greenenergyprojects/rpi-atmega324-modbus-gateway/kicad/dist/rpi-atmega324-modbus-gateway-min_image-bottom.png

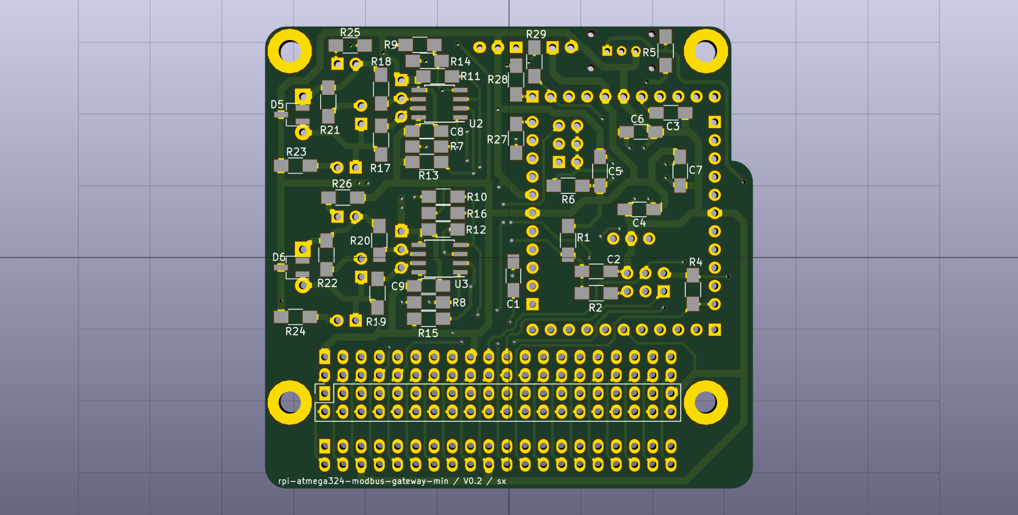
kicad/dist/rpi-atmega324-modbus-gateway-min_image-bottom.png
