greenenergyprojects/rpi-atmega324-modbus-gateway/README.md

# rpi-atmega324-modbus-gateway
Modbus Gateway for Raspberry PI
