greenenergyprojects/rpi-atmega324-modbus-gateway/kicad/prototype/pinning.odt

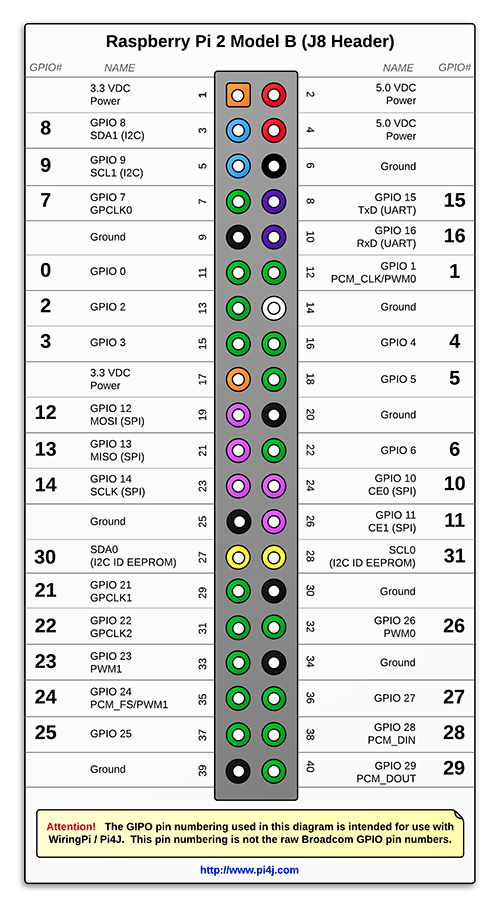
[picture p3: figure]
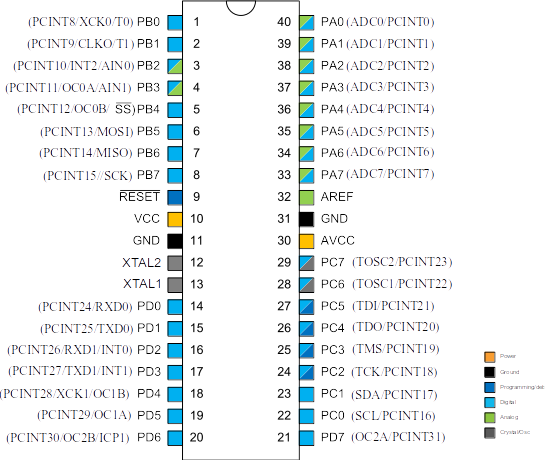
[picture p4: figure]
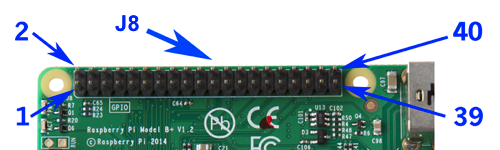
[picture p5: figure]
