greenenergyprojects/rpi-atmega324-modbus-gateway/kicad/dist/rpi-atmega324-modbus-gateway-min_bom.ods

Source: | /work/sx/gep/rpi-atmega324-modbus-gateway/kicad/rpi-atmega324-modbus-gateway-min.sch
Date: | Fr 31 Aug 2018 14:42:01 CEST
Tool: | Eeschema 4.0.7-e2-6376~61~ubuntu18.04.1
Component Count: | 73
Ref | Value | Footprint | Datasheet | Manufacturer | Vendor
C1 | 100n | Capacitors_SMD:C_1206_HandSoldering
C2 | 1n | Capacitors_SMD:C_1206_HandSoldering
C3 | 100n | Capacitors_SMD:C_1206_HandSoldering
C4 | 100n | Capacitors_SMD:C_1206_HandSoldering
C5 | 100n | Capacitors_SMD:C_1206_HandSoldering
C6 | 100n | Capacitors_SMD:C_1206_HandSoldering
C7 | 100n | Capacitors_SMD:C_1206_HandSoldering
C8 | 100n | Capacitors_SMD:C_1206_HandSoldering
C9 | 100n | Capacitors_SMD:C_1206_HandSoldering
D1 | LED | LEDs:LED_0805_HandSoldering
D2 | LED | LEDs:LED_0805_HandSoldering
D3 | LED | LEDs:LED_0805_HandSoldering
D4 | LED | LEDs:LED_0805_HandSoldering
D5 | D_TVS_x2_AAC | TO_SOT_Packages_SMD:SOT-23_Handsoldering
D6 | D_TVS_x2_AAC | TO_SOT_Packages_SMD:SOT-23_Handsoldering
D7 | LED | LEDs:LED_0805_HandSoldering
D8 | LED | LEDs:LED_0805_HandSoldering
D9 | LED | LEDs:LED_0805_HandSoldering
J1 | Raspberry_Pi_2+ | Project:RPI_DINRAILBOX_4TE_72mmx91mm_DEBUG
J2 | UART-Harwin3 | Connectors_Harwin:Harwin_LTek-Male_03x2.00mm_Straight_StrainRelief
J3 | Conn_01x02 | Pin_Headers:Pin_Header_Straight_1x02_Pitch2.54mm
J4 | Conn_02x03_Odd_Even | Project:Jumper_3x_2x03_Pitch2.54mm
J5 | Atmega-ISP-6 | Project:IDC_2x3x2.54mm_Straight
J6 | Conn_01x03 | Pin_Headers:Pin_Header_Straight_1x03_Pitch2.54mm
J7 | Conn_01x03 | Pin_Headers:Pin_Header_Straight_1x03_Pitch2.54mm
J8 | Conn_01x02 | Pin_Headers:Pin_Header_Straight_1x02_Pitch2.54mm
J9 | Conn_01x02 | Pin_Headers:Pin_Header_Straight_1x02_Pitch2.54mm
J10 | Conn_01x02 | Pin_Headers:Pin_Header_Straight_1x02_Pitch2.54mm
J11 | Conn_01x02 | Pin_Headers:Pin_Header_Straight_1x02_Pitch2.54mm
J12 | Conn_01x02 | Pin_Headers:Pin_Header_Straight_1x02_Pitch2.54mm
J13 | Conn_01x02 | Pin_Headers:Pin_Header_Straight_1x02_Pitch2.54mm
J14 | Screw_Terminal_01x02 | Project:Terminalblock-2x-5mm
J15 | Screw_Terminal_01x02 | Project:Terminalblock-2x-5mm
J16 | Conn_01x11 | Pin_Headers:Pin_Header_Straight_1x11_Pitch2.54mm
J17 | Conn_01x11 | Pin_Headers:Pin_Header_Straight_1x11_Pitch2.54mm
J18 | Conn_01x11 | Pin_Headers:Pin_Header_Straight_1x11_Pitch2.54mm
J19 | Conn_01x11 | Pin_Headers:Pin_Header_Straight_1x11_Pitch2.54mm
JP1 | Jumper_NC_Small | Project:SOLDER-JUMPER_1-WAY
R1 | 10K | Resistors_SMD:R_1206_HandSoldering
R2 | 10K | Resistors_SMD:R_1206_HandSoldering
R3 | 47K | Resistors_SMD:R_1206_HandSoldering
R4 | 47K | Resistors_SMD:R_1206_HandSoldering
R5 | 47K | Resistors_SMD:R_1206_HandSoldering
R6 | 47K | Resistors_SMD:R_1206_HandSoldering
R7 | 560R | Resistors_SMD:R_1206_HandSoldering
R8 | 560R | Resistors_SMD:R_1206_HandSoldering
R9 | 560R | Resistors_SMD:R_1206_HandSoldering
R10 | 560R | Resistors_SMD:R_1206_HandSoldering
R11 | 47K | Resistors_SMD:R_1206_HandSoldering
R12 | 47K | Resistors_SMD:R_1206_HandSoldering
R13 | 47K | Resistors_SMD:R_1206_HandSoldering
R14 | 47K | Resistors_SMD:R_1206_HandSoldering
R15 | 47K | Resistors_SMD:R_1206_HandSoldering
R16 | 47K | Resistors_SMD:R_1206_HandSoldering
R17 | 10R | Resistors_SMD:R_1206_HandSoldering
R18 | 10R | Resistors_SMD:R_1206_HandSoldering
R19 | 10R | Resistors_SMD:R_1206_HandSoldering
R20 | 10R | Resistors_SMD:R_1206_HandSoldering
R21 | 150R | Resistors_SMD:R_1206_HandSoldering
R22 | 150R | Resistors_SMD:R_1206_HandSoldering
R23 | 330R | Resistors_SMD:R_1206_HandSoldering
R24 | 330R | Resistors_SMD:R_1206_HandSoldering
R25 | 330R | Resistors_SMD:R_1206_HandSoldering
R26 | 330R | Resistors_SMD:R_1206_HandSoldering
R27 | 560R | Resistors_SMD:R_1206_HandSoldering
R28 | 560R | Resistors_SMD:R_1206_HandSoldering
R29 | 560R | Resistors_SMD:R_1206_HandSoldering
SW1 | SW_Push | Buttons_Switches_SMD:SW_SPST_FSMSM
SW2 | SW_SPST | Project:SW-ebay-171865305033
U1 | ATMEGA324P-20AU | Project:TQFP-44_10x10mm_Pitch0.8mm_Handsolded
U2 | SN65HVD11 | Project:SOIC-8_3.9x4.9mm_Pitch1.27mm_Handsolded
U3 | SN65HVD11 | Project:SOIC-8_3.9x4.9mm_Pitch1.27mm_Handsolded
Y1 | 12MHz | Crystals:Resonator-3pin_w7.0mm_h2.5mm
