greenenergyprojects/rpi-atmega324-modbus-gateway/software/atmega324p/simple-gateway/measurements/osci/modbus_gateway_oszi_2018-08-08_08-25.png

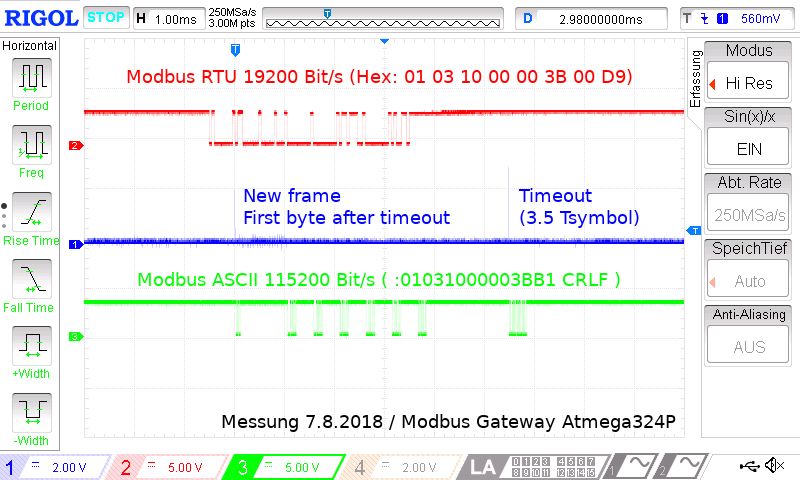
software/atmega324p/simple-gateway/measurements/osci/modbus_gateway_oszi_2018-08-08_08-25.png
