greenenergyprojects/rpi-atmega324-modbus-gateway/kicad/dist/rpi-atmega324-modbus-gateway-min_schematic-bw.pdf

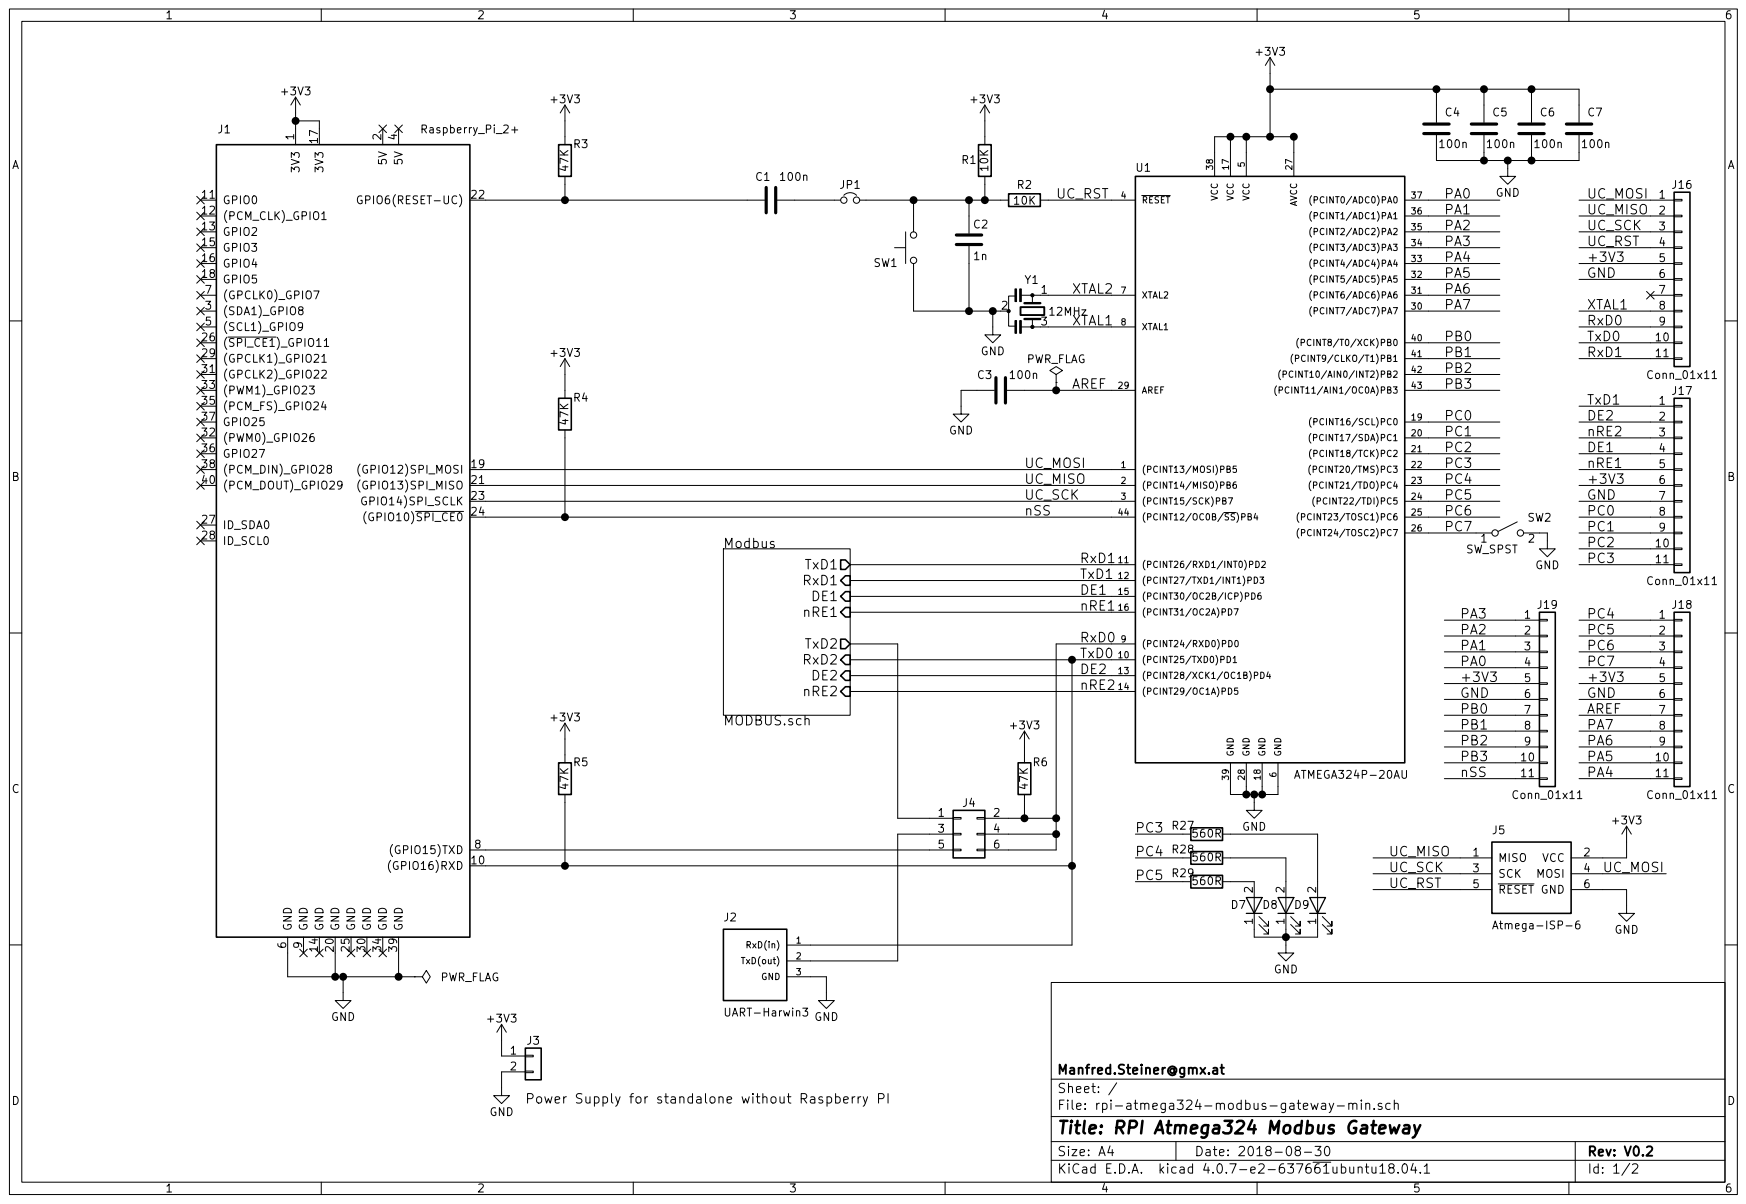
[picture p7: page 1]

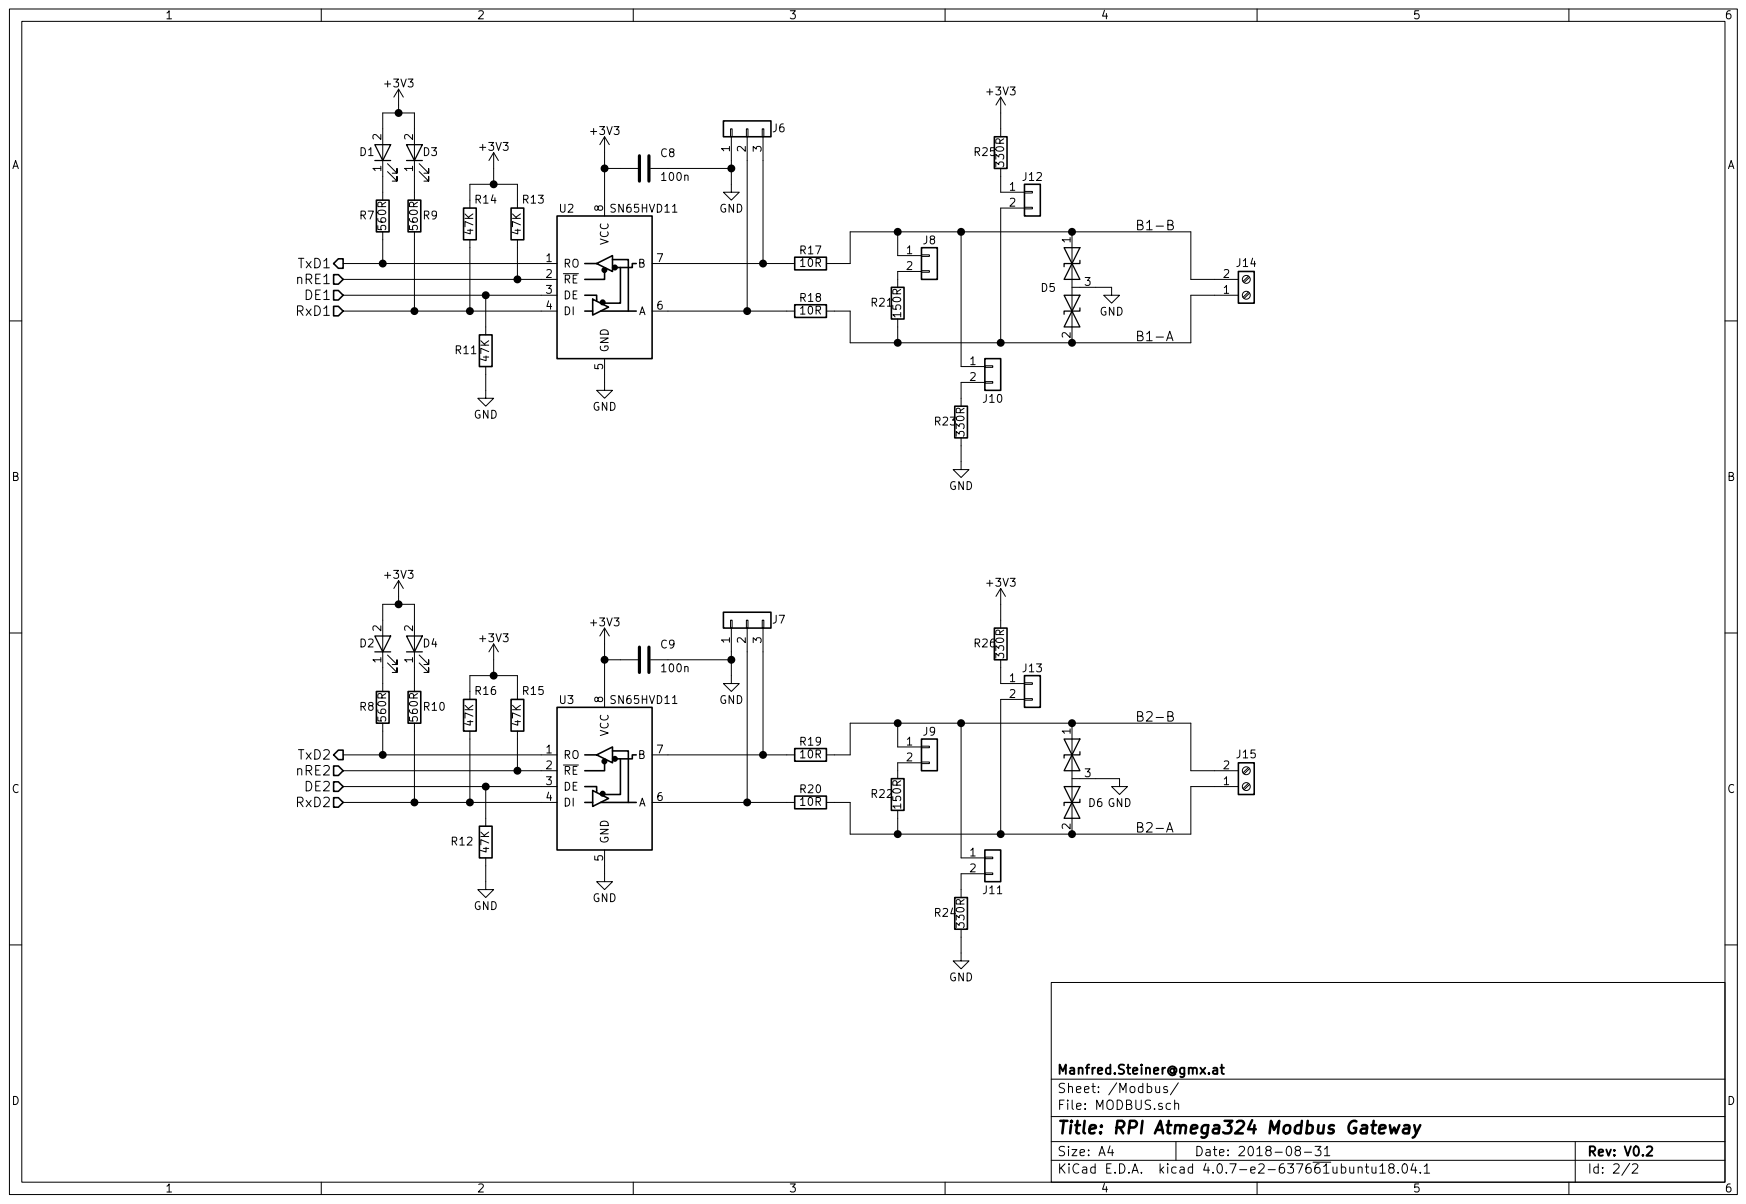
[picture p8: page 2]
