greenenergyprojects/rpi-atmega324-modbus-gateway/kicad/dist/rpi-atmega324-modbus-gateway-min_schematic.pdf

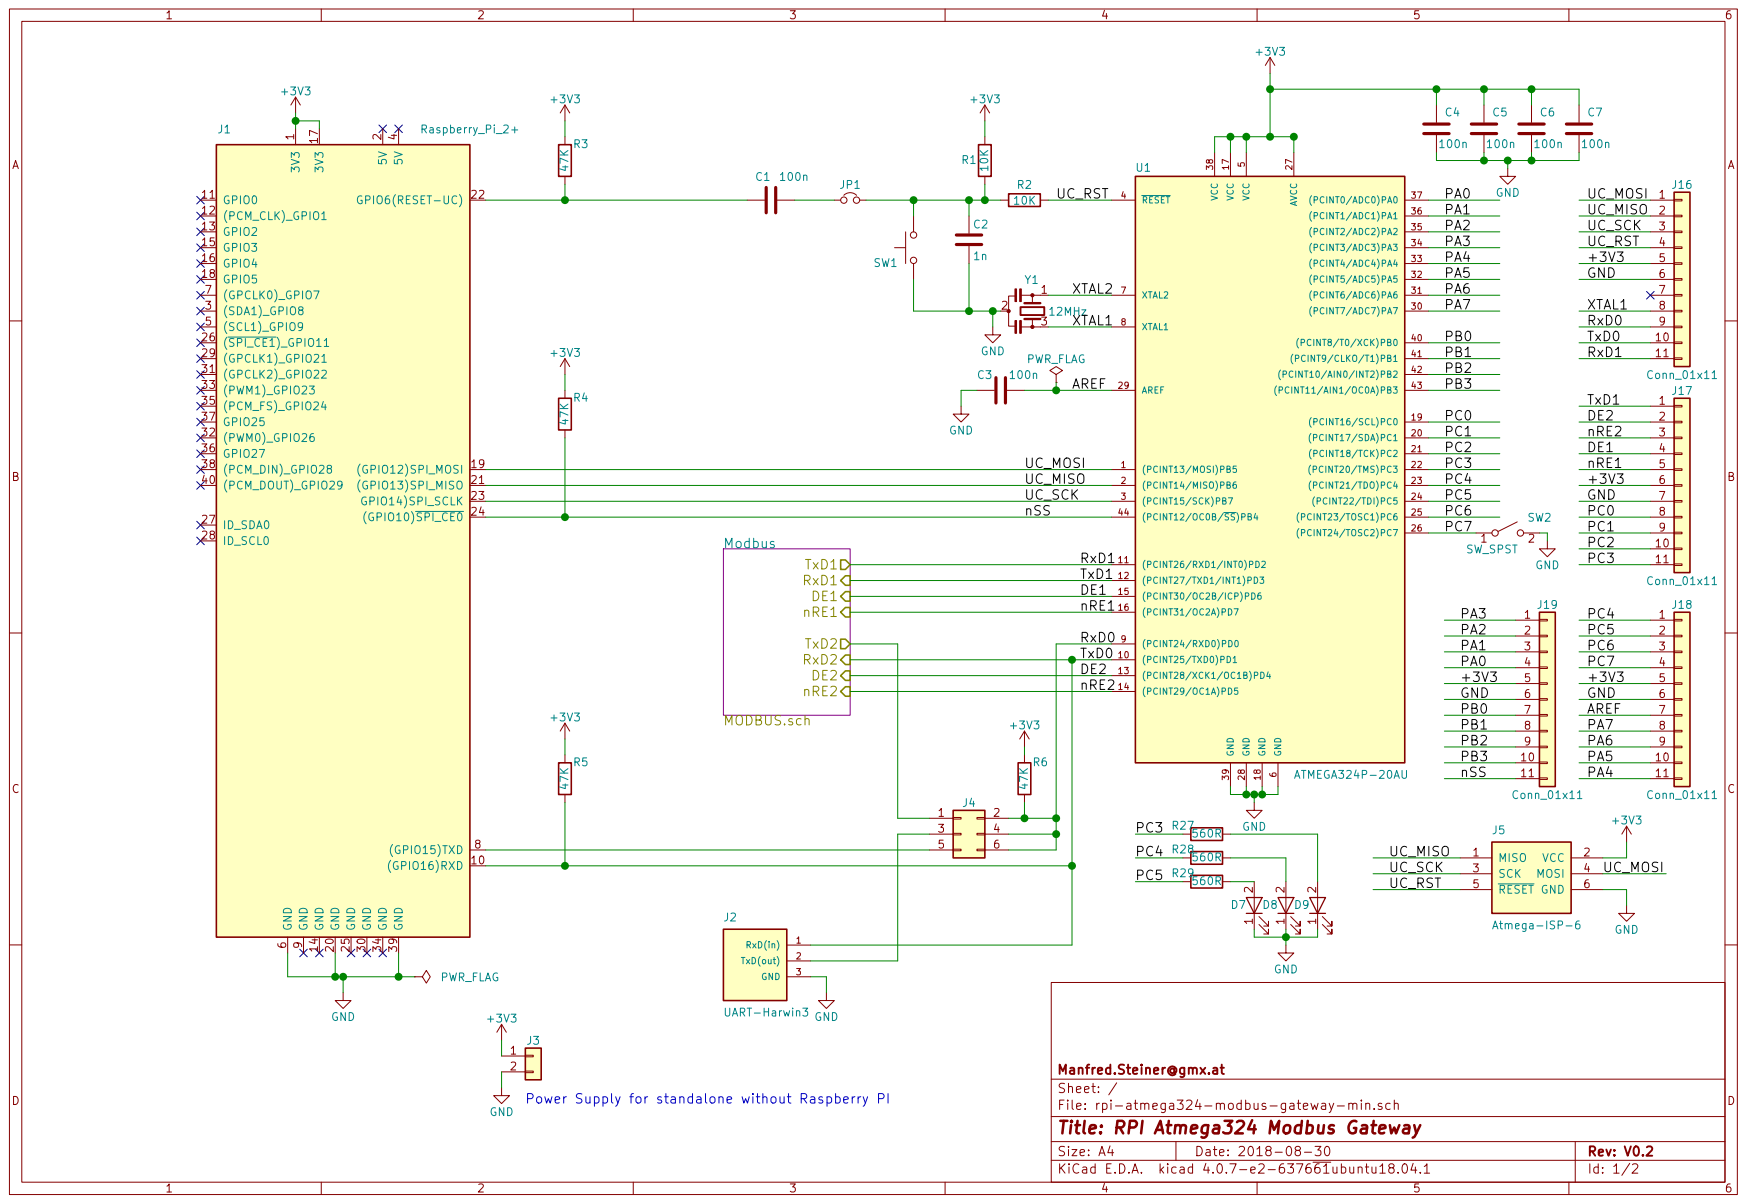
[picture p9: page 1]

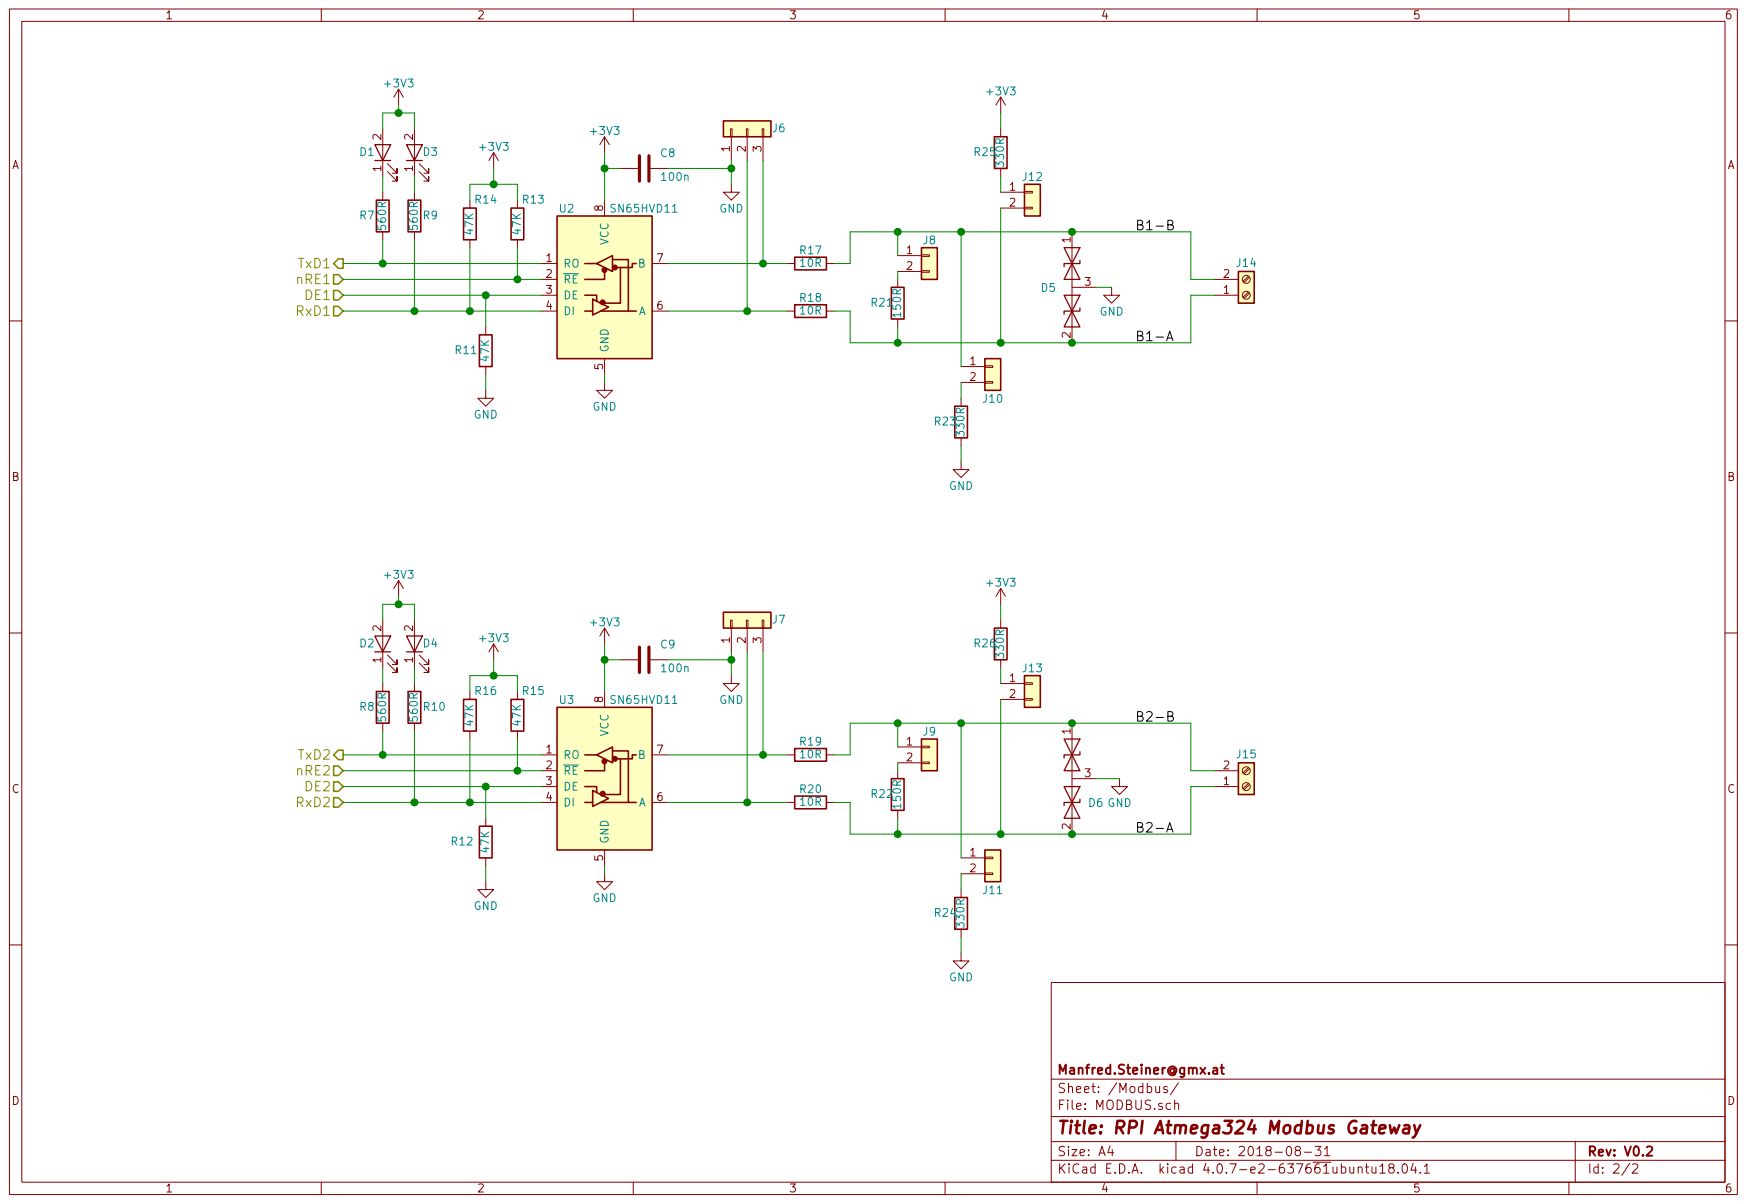
[picture p10: page 2]
