greenenergyprojects/rpi-atmega324-modbus-gateway/kicad/rpi-atmega324-modbus-gateway-min.kicad_pcb

## KiCad design kicad/rpi-atmega324-modbus-gateway-min.kicad_pcb (2018-08-31)

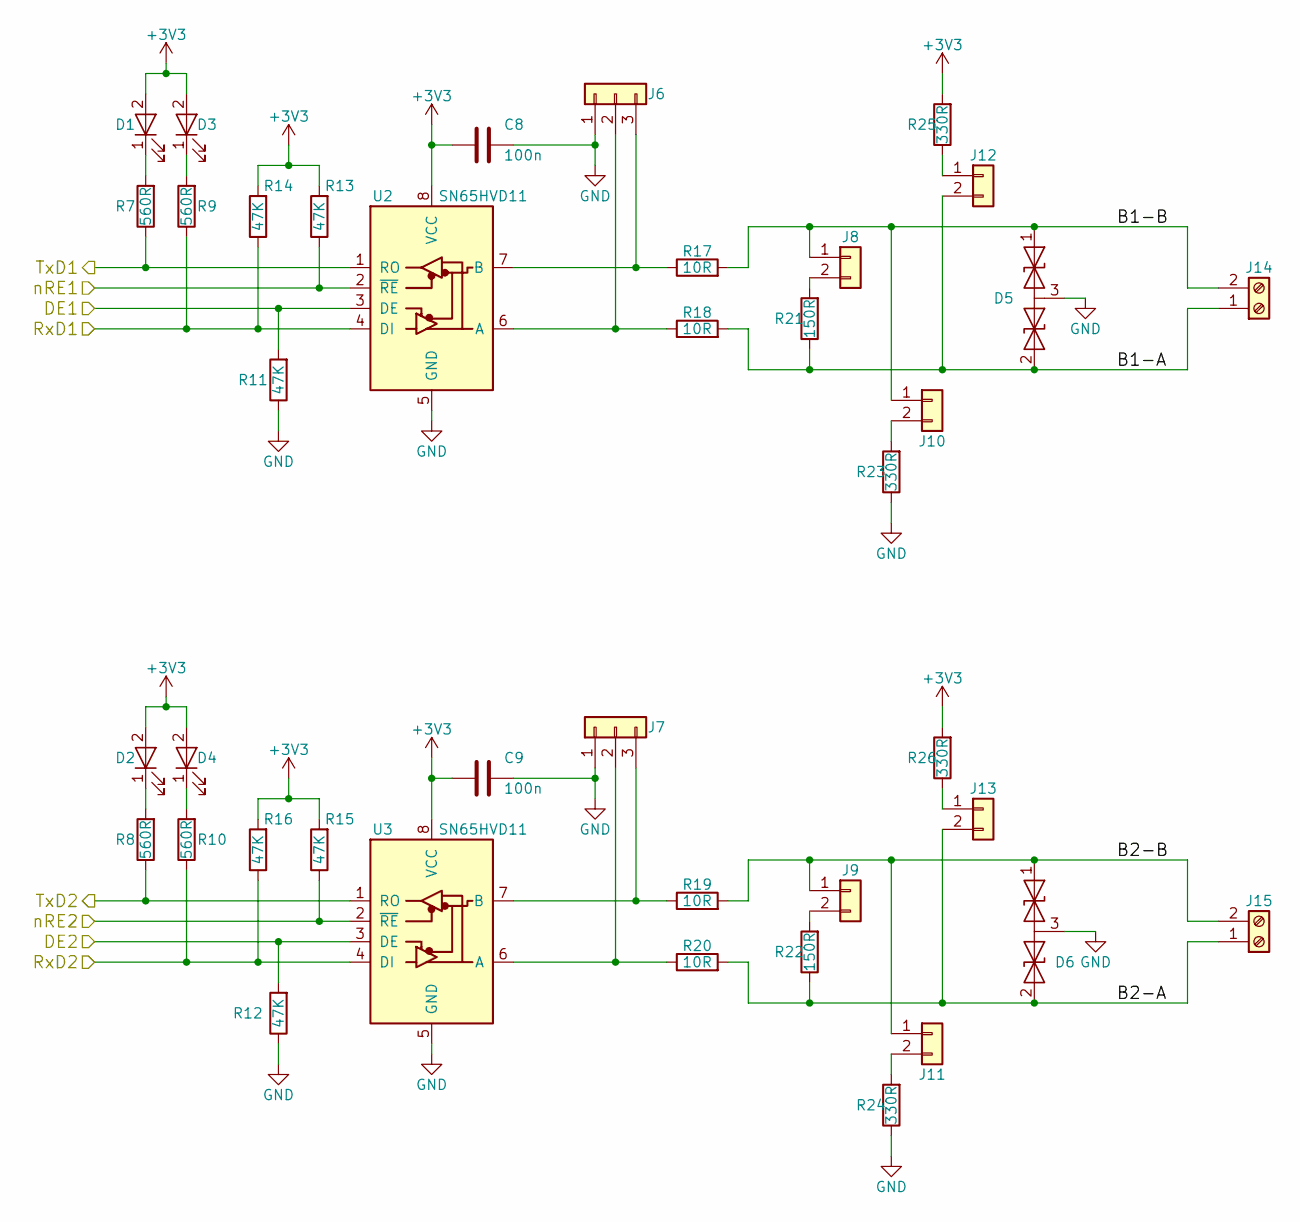
[picture p18: schematic MODBUS-2020-11-14-15-20-30.sch, RPI Atmega324 Modbus Gateway]

Parts:
C8, C9: 100n; C_1206_HandSoldering
D1, D2, D3, D4: LED; LED_0805_HandSoldering
D5, D6: D_TVS_x2_AAC; SOT-23_Handsoldering
J6, J7: Conn_01x03; Pin_Header_Straight_1x03_Pitch2.54mm
J8, J9, J10, J11, J12, J13: Conn_01x02; Pin_Header_Straight_1x02_Pitch2.54mm
J14, J15: Screw_Terminal_01x02; Terminalblock-2x-5mm
R7, R8, R9, R10: 560R; R_1206_HandSoldering
R11, R12, R13, R14, R15, R16: 47K; R_1206_HandSoldering
R17, R18, R19, R20: 10R; R_1206_HandSoldering
R21, R22: 150R; R_1206_HandSoldering
R23, R24, R25, R26: 330R; R_1206_HandSoldering
U2, U3: SN65HVD11; SOIC-8_3.9x4.9mm_Pitch1.27mm_Handsolded

Connections:
+3V3: C8.2, C9.2, D1.2 (A), D2.2 (A), D3.2 (A), D4.2 (A), R13.2, R14.2, R15.2, R16.2, R25.2, R26.2, U2.8 (VCC), U3.8 (VCC); also elsewhere on the board
/DE1: R11.2, U2.3 (DE); also elsewhere on the board
/DE2: R12.2, U3.3 (DE); also elsewhere on the board
/Modbus/B1-A: D5.2 (A2), J12.2, J14.1, R18.2, R21.1
/Modbus/B1-B: D5.1 (A1), J8.1, J10.1, J14.2, R17.2
/Modbus/B2-A: D6.2 (A2), J13.2, J15.1, R20.2, R22.1
/Modbus/B2-B: D6.1 (A1), J9.1, J11.1, J15.2, R19.2
/Modbus/TxD2: R8.1, U3.1 (RO); also elsewhere on the board
/RxD1: R7.1, U2.1 (RO); also elsewhere on the board
/TxD0: R10.1, R16.1, U3.4 (DI); also elsewhere on the board
/TxD1: R9.1, R14.1, U2.4 (DI); also elsewhere on the board
/nRE1: R13.1, U2.2 (~RE); also elsewhere on the board
/nRE2: R15.1, U3.2 (~RE); also elsewhere on the board
GND: C8.1, C9.1, D5.3 (common), D6.3 (common), J6.1, J7.1, R11.1, R12.1, R23.1, R24.1, U2.5 (GND), U3.5 (GND); also elsewhere on the board
unnamed: D1.1 (K), R7.2
unnamed: D2.1 (K), R8.2
unnamed: D3.1 (K), R9.2
unnamed: D4.1 (K), R10.2
unnamed: J6.2, R18.1, U2.6 (A)
unnamed: J6.3, R17.1, U2.7 (B)
unnamed: J7.2, R20.1, U3.6 (A)
unnamed: J7.3, R19.1, U3.7 (B)
unnamed: J8.2, R21.2
unnamed: J9.2, R22.2
unnamed: J10.2, R23.2
unnamed: J11.2, R24.2
unnamed: J12.1, R25.1
unnamed: J13.1, R26.1


Parts:
C8, C9: 100n; C_1206_HandSoldering
D1, D2, D3, D4: LED; LED_0805_HandSoldering
D5, D6: D_TVS_x2_AAC; SOT-23_Handsoldering
J6, J7: Conn_01x03; Pin_Header_Straight_1x03_Pitch2.54mm
J8, J9, J10, J11, J12, J13: Conn_01x02; Pin_Header_Straight_1x02_Pitch2.54mm
J14, J15: Screw_Terminal_01x02; Terminalblock-2x-5mm
R7, R8, R9, R10: 560R; R_1206_HandSoldering
R11, R12, R13, R14, R15, R16: 47K; R_1206_HandSoldering
R17, R18, R19, R20: 10R; R_1206_HandSoldering
R21, R22: 150R; R_1206_HandSoldering
R23, R24, R25, R26: 330R; R_1206_HandSoldering
U2, U3: SN65HVD11; SOIC-8_3.9x4.9mm_Pitch1.27mm_Handsolded

Connections:
+3V3: C8.2, C9.2, D1.2 (A), D2.2 (A), D3.2 (A), D4.2 (A), R13.2, R14.2, R15.2, R16.2, R25.2, R26.2, U2.8 (VCC), U3.8 (VCC); also elsewhere on the board
/DE1: R11.2, U2.3 (DE); also elsewhere on the board
/DE2: R12.2, U3.3 (DE); also elsewhere on the board
/Modbus/B1-A: D5.2 (A2), J12.2, J14.1, R18.2, R21.1
/Modbus/B1-B: D5.1 (A1), J8.1, J10.1, J14.2, R17.2
/Modbus/B2-A: D6.2 (A2), J13.2, J15.1, R20.2, R22.1
/Modbus/B2-B: D6.1 (A1), J9.1, J11.1, J15.2, R19.2
/Modbus/TxD2: R8.1, U3.1 (RO); also elsewhere on the board
/RxD1: R7.1, U2.1 (RO); also elsewhere on the board
/TxD0: R10.1, R16.1, U3.4 (DI); also elsewhere on the board
/TxD1: R9.1, R14.1, U2.4 (DI); also elsewhere on the board
/nRE1: R13.1, U2.2 (~RE); also elsewhere on the board
/nRE2: R15.1, U3.2 (~RE); also elsewhere on the board
GND: C8.1, C9.1, D5.3 (common), D6.3 (common), J6.1, J7.1, R11.1, R12.1, R23.1, R24.1, U2.5 (GND), U3.5 (GND); also elsewhere on the board
unnamed: D1.1 (K), R7.2
unnamed: D2.1 (K), R8.2
unnamed: D3.1 (K), R9.2
unnamed: D4.1 (K), R10.2
unnamed: J6.2, R18.1, U2.6 (A)
unnamed: J6.3, R17.1, U2.7 (B)
unnamed: J7.2, R20.1, U3.6 (A)
unnamed: J7.3, R19.1, U3.7 (B)
unnamed: J8.2, R21.2
unnamed: J9.2, R22.2
unnamed: J10.2, R23.2
unnamed: J11.2, R24.2
unnamed: J12.1, R25.1
unnamed: J13.1, R26.1

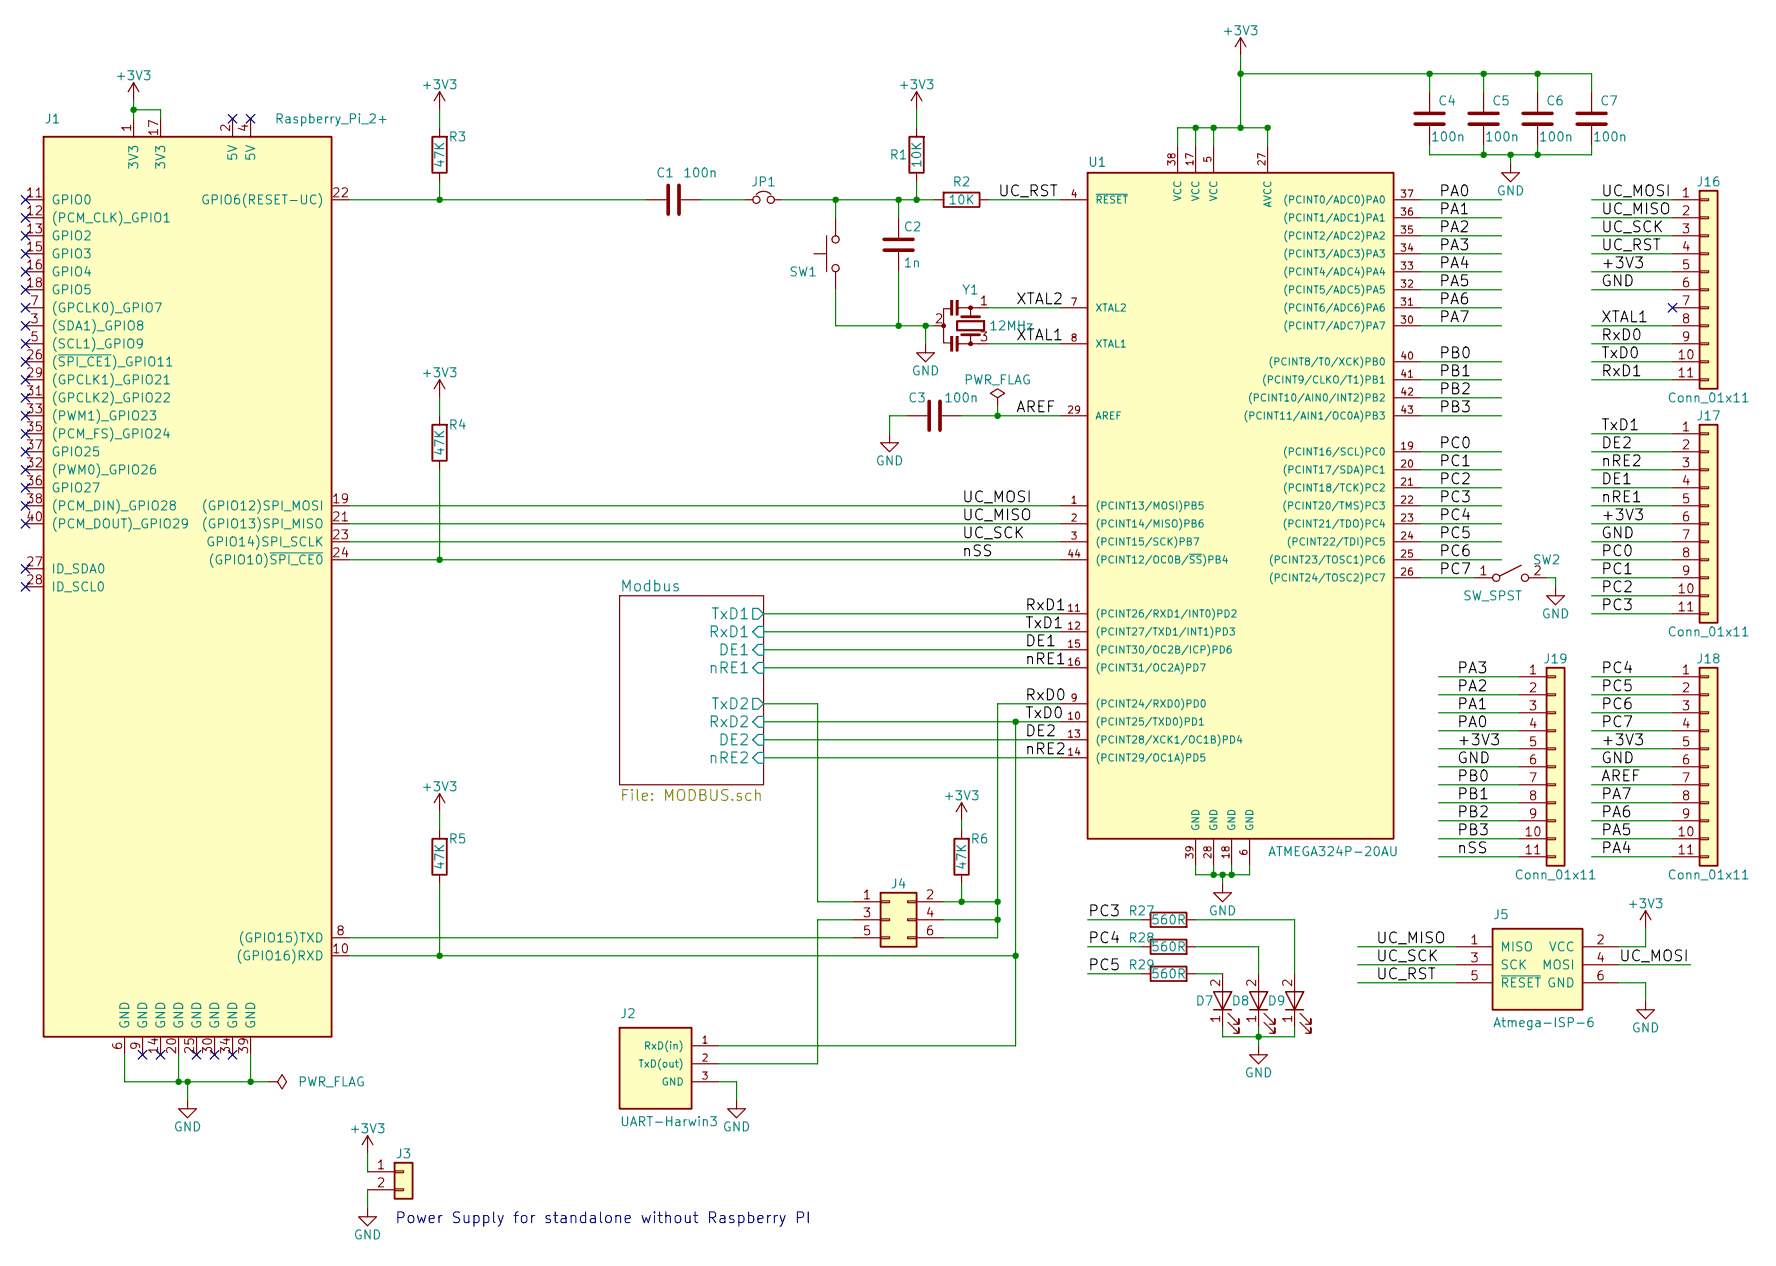
[picture p19: schematic rpi-atmega324-modbus-gateway-min-2020-11-14-15-20-30.sch, RPI Atmega324 Modbus Gateway]

Parts:
C1, C3, C4, C5, C6, C7: 100n; C_1206_HandSoldering
C2: 1n; C_1206_HandSoldering
D7, D8, D9: LED; LED_0805_HandSoldering
J1: Raspberry_Pi_2+; RPI_DINRAILBOX_4TE_72mmx91mm_DEBUG
J2: UART-Harwin3; Harwin_LTek-Male_03x2.00mm_Straight_StrainRelief
J3: Conn_01x02; Pin_Header_Straight_1x02_Pitch2.54mm
J4: Conn_02x03_Odd_Even; Jumper_3x_2x03_Pitch2.54mm
J5: Atmega-ISP-6; IDC_2x3x2.54mm_Straight
J16, J17, J18, J19: Conn_01x11; Pin_Header_Straight_1x11_Pitch2.54mm
JP1: Jumper_NC_Small; SOLDER-JUMPER_1-WAY
R1, R2: 10K; R_1206_HandSoldering
R3, R4, R5, R6: 47K; R_1206_HandSoldering
R27, R28, R29: 560R; R_1206_HandSoldering
SW1: SW_Push; SW_SPST_FSMSM
SW2: SW_SPST; SW-ebay-171865305033
U1: ATMEGA324P-20AU; TQFP-44_10x10mm_Pitch0.8mm_Handsolded
Y1: 12MHz; Resonator-3pin_w7.0mm_h2.5mm

Connections:
+3V3: C4.2, C5.2, C6.2, C7.2, J1.1 (3V3), J1.17 (3V3), J3.1, J5.2 (VCC), J16.5, J17.6, J18.5, J19.5, R1.2, R3.2, R4.2, R5.2, R6.2, U1.5 (VCC), U1.17 (VCC), U1.27 (AVCC), U1.38 (VCC); also elsewhere on the board
/AREF: C3.1, J18.7, U1.29 (AREF)
/DE1: J17.4, U1.15 ((PCINT30/OC2B/ICP)PD6); also elsewhere on the board
/DE2: J17.2, U1.13 ((PCINT28/XCK1/OC1B)PD4); also elsewhere on the board
/Modbus/TxD2: J4.1; also elsewhere on the board
/PA0: J19.4, U1.37 ((PCINT0/ADC0)PA0)
/PA1: J19.3, U1.36 ((PCINT1/ADC1)PA1)
/PA2: J19.2, U1.35 ((PCINT2/ADC2)PA2)
/PA3: J19.1, U1.34 ((PCINT3/ADC3)PA3)
/PA4: J18.11, U1.33 ((PCINT4/ADC4)PA4)
/PA5: J18.10, U1.32 ((PCINT5/ADC5)PA5)
/PA6: J18.9, U1.31 ((PCINT6/ADC6)PA6)
/PA7: J18.8, U1.30 ((PCINT7/ADC7)PA7)
/PB0: J19.7, U1.40 ((PCINT8/T0/XCK)PB0)
/PB1: J19.8, U1.41 ((PCINT9/CLKO/T1)PB1)
/PB2: J19.9, U1.42 ((PCINT10/AIN0/INT2)PB2)
/PB3: J19.10, U1.43 ((PCINT11/AIN1/OC0A)PB3)
/PC0: J17.8, U1.19 ((PCINT16/SCL)PC0)
/PC1: J17.9, U1.20 ((PCINT17/SDA)PC1)
/PC2: J17.10, U1.21 ((PCINT18/TCK)PC2)
/PC3: J17.11, R27.1, U1.22 ((PCINT20/TMS)PC3)
/PC4: J18.1, R28.1, U1.23 ((PCINT21/TDO)PC4)
/PC5: J18.2, R29.1, U1.24 ((PCINT22/TDI)PC5)
/PC6: J18.3, U1.25 ((PCINT23/TOSC1)PC6)
/PC7: J18.4, SW2.1 (A), U1.26 ((PCINT24/TOSC2)PC7)
/RxD0: J4.2, J4.4, J4.6, J16.9, R6.1, U1.9 ((PCINT24/RXD0)PD0)
/RxD1: J16.11, U1.11 ((PCINT26/RXD1/INT0)PD2); also elsewhere on the board
/TxD0: J1.10 ((GPIO16)RXD), J2.1 (RxD(in)), J16.10, R5.1, U1.10 ((PCINT25/TXD0)PD1); also elsewhere on the board
/TxD1: J17.1, U1.12 ((PCINT27/TXD1/INT1)PD3); also elsewhere on the board
/UC_MISO: J1.21 ((GPIO13)SPI_MISO), J5.1 (MISO), J16.2, U1.2 ((PCINT14/MISO)PB6)
/UC_MOSI: J1.19 ((GPIO12)SPI_MOSI), J5.4 (MOSI), J16.1, U1.1 ((PCINT13/MOSI)PB5)
/UC_RST: J5.5 (~RESET~), J16.4, R2.1, U1.4 (~RESET)
/UC_SCK: J1.23 (GPIO14)SPI_SCLK), J5.3 (SCK), J16.3, U1.3 ((PCINT15/SCK)PB7)
/XTAL1: J16.8, U1.8 (XTAL1), Y1.3
/XTAL2: U1.7 (XTAL2), Y1.1
/nRE1: J17.5, U1.16 ((PCINT31/OC2A)PD7); also elsewhere on the board
/nRE2: J17.3, U1.14 ((PCINT29/OC1A)PD5); also elsewhere on the board
/nSS: J1.24 ((GPIO10)~SPI_CE0~), J19.11, R4.1, U1.44 ((PCINT12/OC0B/~SS~)PB4)
GND: C2.2, C3.2, C4.1, C5.1, C6.1, C7.1, D7.1 (K), D8.1 (K), D9.1 (K), J1.6 (GND), J1.20 (GND), J1.39 (GND), J2.3 (GND), J3.2, J5.6 (GND), J16.6, J17.7, J18.6, J19.6, SW1.1, SW2.2 (B), U1.6 (GND), U1.18 (GND), U1.28 (GND), U1.39 (GND), Y1.2; also elsewhere on the board
unnamed: C1.1, JP1.1
unnamed: C1.2, J1.22 (GPIO6(RESET-UC)), R3.1
unnamed: C2.1, JP1.2, R1.1, R2.2, SW1.2
unnamed: D7.2 (A), R29.2
unnamed: D8.2 (A), R28.2
unnamed: D9.2 (A), R27.2
unnamed: J1.8 ((GPIO15)TXD), J4.5
unnamed: J2.2 (TxD(out)), J4.3

Notes on the sheet:
Power Supply for standalone without Raspberry PI


Parts:
C1, C3, C4, C5, C6, C7: 100n; C_1206_HandSoldering
C2: 1n; C_1206_HandSoldering
D7, D8, D9: LED; LED_0805_HandSoldering
J1: Raspberry_Pi_2+; RPI_DINRAILBOX_4TE_72mmx91mm_DEBUG
J2: UART-Harwin3; Harwin_LTek-Male_03x2.00mm_Straight_StrainRelief
J3: Conn_01x02; Pin_Header_Straight_1x02_Pitch2.54mm
J4: Conn_02x03_Odd_Even; Jumper_3x_2x03_Pitch2.54mm
J5: Atmega-ISP-6; IDC_2x3x2.54mm_Straight
J16, J17, J18, J19: Conn_01x11; Pin_Header_Straight_1x11_Pitch2.54mm
JP1: Jumper_NC_Small; SOLDER-JUMPER_1-WAY
R1, R2: 10K; R_1206_HandSoldering
R3, R4, R5, R6: 47K; R_1206_HandSoldering
R27, R28, R29: 560R; R_1206_HandSoldering
SW1: SW_Push; SW_SPST_FSMSM
SW2: SW_SPST; SW-ebay-171865305033
U1: ATMEGA324P-20AU; TQFP-44_10x10mm_Pitch0.8mm_Handsolded
Y1: 12MHz; Resonator-3pin_w7.0mm_h2.5mm

Connections:
+3V3: C4.2, C5.2, C6.2, C7.2, J1.1 (3V3), J1.17 (3V3), J3.1, J5.2 (VCC), J16.5, J17.6, J18.5, J19.5, R1.2, R3.2, R4.2, R5.2, R6.2, U1.5 (VCC), U1.17 (VCC), U1.27 (AVCC), U1.38 (VCC); also elsewhere on the board
/AREF: C3.1, J18.7, U1.29 (AREF)
/DE1: J17.4, U1.15 ((PCINT30/OC2B/ICP)PD6); also elsewhere on the board
/DE2: J17.2, U1.13 ((PCINT28/XCK1/OC1B)PD4); also elsewhere on the board
/Modbus/TxD2: J4.1; also elsewhere on the board
/PA0: J19.4, U1.37 ((PCINT0/ADC0)PA0)
/PA1: J19.3, U1.36 ((PCINT1/ADC1)PA1)
/PA2: J19.2, U1.35 ((PCINT2/ADC2)PA2)
/PA3: J19.1, U1.34 ((PCINT3/ADC3)PA3)
/PA4: J18.11, U1.33 ((PCINT4/ADC4)PA4)
/PA5: J18.10, U1.32 ((PCINT5/ADC5)PA5)
/PA6: J18.9, U1.31 ((PCINT6/ADC6)PA6)
/PA7: J18.8, U1.30 ((PCINT7/ADC7)PA7)
/PB0: J19.7, U1.40 ((PCINT8/T0/XCK)PB0)
/PB1: J19.8, U1.41 ((PCINT9/CLKO/T1)PB1)
/PB2: J19.9, U1.42 ((PCINT10/AIN0/INT2)PB2)
/PB3: J19.10, U1.43 ((PCINT11/AIN1/OC0A)PB3)
/PC0: J17.8, U1.19 ((PCINT16/SCL)PC0)
/PC1: J17.9, U1.20 ((PCINT17/SDA)PC1)
/PC2: J17.10, U1.21 ((PCINT18/TCK)PC2)
/PC3: J17.11, R27.1, U1.22 ((PCINT20/TMS)PC3)
/PC4: J18.1, R28.1, U1.23 ((PCINT21/TDO)PC4)
/PC5: J18.2, R29.1, U1.24 ((PCINT22/TDI)PC5)
/PC6: J18.3, U1.25 ((PCINT23/TOSC1)PC6)
/PC7: J18.4, SW2.1 (A), U1.26 ((PCINT24/TOSC2)PC7)
/RxD0: J4.2, J4.4, J4.6, J16.9, R6.1, U1.9 ((PCINT24/RXD0)PD0)
/RxD1: J16.11, U1.11 ((PCINT26/RXD1/INT0)PD2); also elsewhere on the board
/TxD0: J1.10 ((GPIO16)RXD), J2.1 (RxD(in)), J16.10, R5.1, U1.10 ((PCINT25/TXD0)PD1); also elsewhere on the board
/TxD1: J17.1, U1.12 ((PCINT27/TXD1/INT1)PD3); also elsewhere on the board
/UC_MISO: J1.21 ((GPIO13)SPI_MISO), J5.1 (MISO), J16.2, U1.2 ((PCINT14/MISO)PB6)
/UC_MOSI: J1.19 ((GPIO12)SPI_MOSI), J5.4 (MOSI), J16.1, U1.1 ((PCINT13/MOSI)PB5)
/UC_RST: J5.5 (~RESET~), J16.4, R2.1, U1.4 (~RESET)
/UC_SCK: J1.23 (GPIO14)SPI_SCLK), J5.3 (SCK), J16.3, U1.3 ((PCINT15/SCK)PB7)
/XTAL1: J16.8, U1.8 (XTAL1), Y1.3
/XTAL2: U1.7 (XTAL2), Y1.1
/nRE1: J17.5, U1.16 ((PCINT31/OC2A)PD7); also elsewhere on the board
/nRE2: J17.3, U1.14 ((PCINT29/OC1A)PD5); also elsewhere on the board
/nSS: J1.24 ((GPIO10)~SPI_CE0~), J19.11, R4.1, U1.44 ((PCINT12/OC0B/~SS~)PB4)
GND: C2.2, C3.2, C4.1, C5.1, C6.1, C7.1, D7.1 (K), D8.1 (K), D9.1 (K), J1.6 (GND), J1.20 (GND), J1.39 (GND), J2.3 (GND), J3.2, J5.6 (GND), J16.6, J17.7, J18.6, J19.6, SW1.1, SW2.2 (B), U1.6 (GND), U1.18 (GND), U1.28 (GND), U1.39 (GND), Y1.2; also elsewhere on the board
unnamed: C1.1, JP1.1
unnamed: C1.2, J1.22 (GPIO6(RESET-UC)), R3.1
unnamed: C2.1, JP1.2, R1.1, R2.2, SW1.2
unnamed: D7.2 (A), R29.2
unnamed: D8.2 (A), R28.2
unnamed: D9.2 (A), R27.2
unnamed: J1.8 ((GPIO15)TXD), J4.5
unnamed: J2.2 (TxD(out)), J4.3

Notes on the sheet:
Power Supply for standalone without Raspberry PI

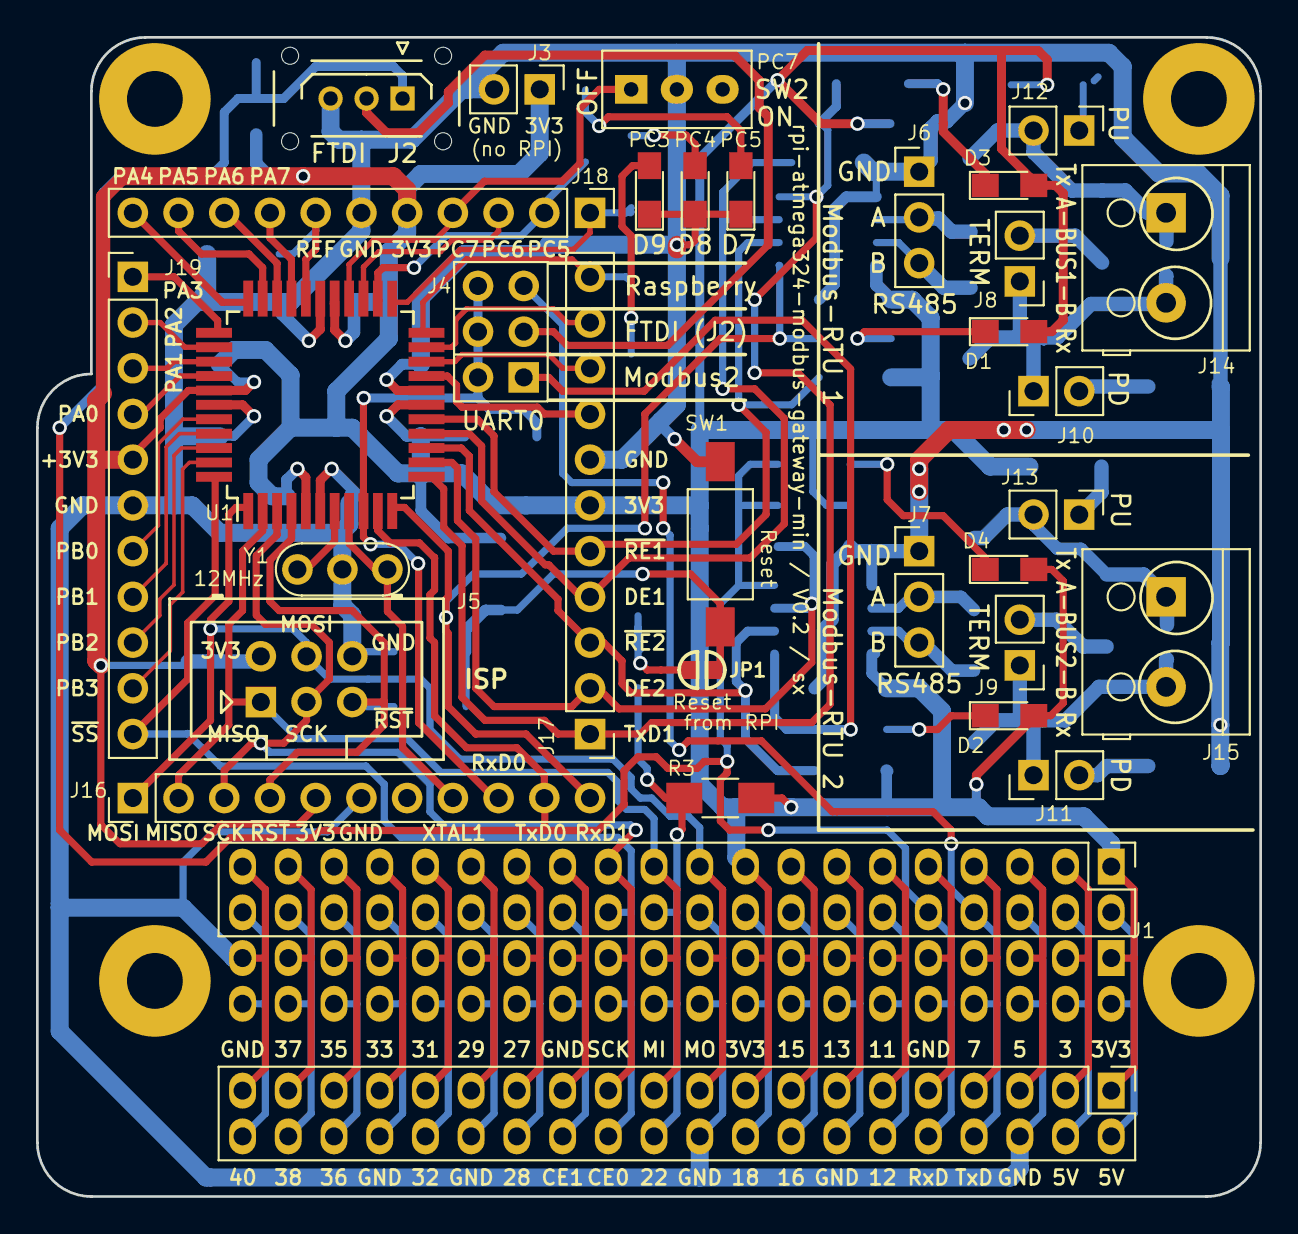
[picture p20: board rpi-atmega324-modbus-gateway-min.kicad_pcb from above]

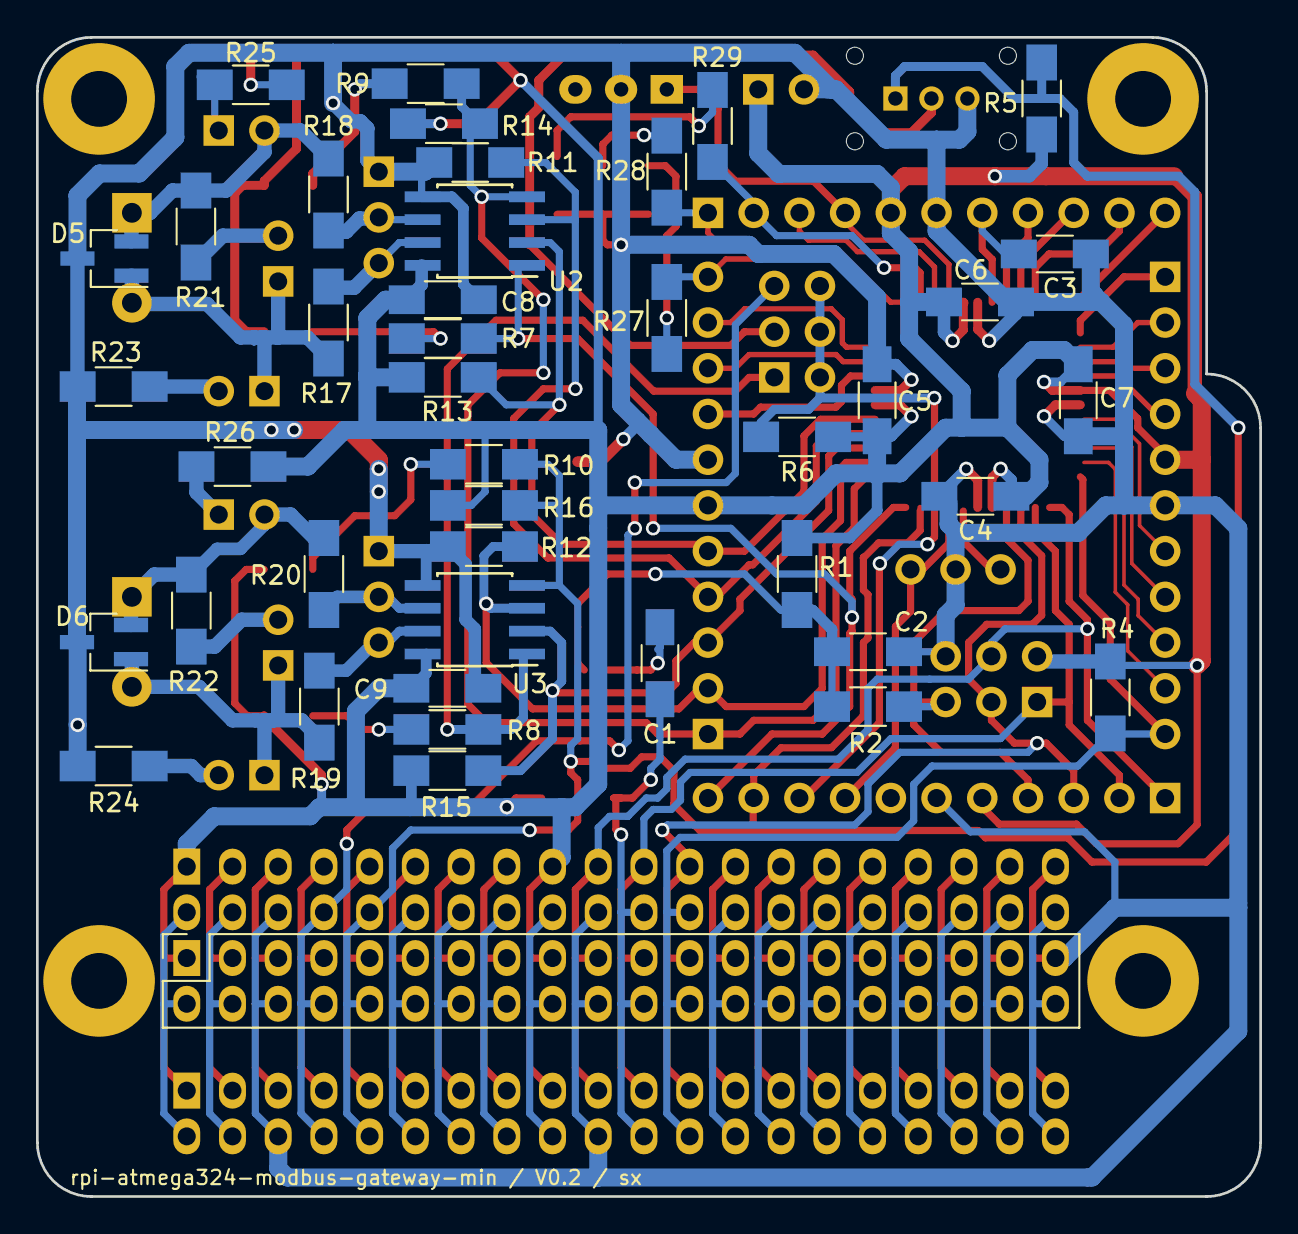
[picture p21: board rpi-atmega324-modbus-gateway-min.kicad_pcb from below]

Board: 2 copper layers, 68.0 x 64.4 mm, 73 parts (41 on the bottom side), 65 nets.
