greenenergyprojects/rpi-atmega324-modbus-gateway/(commit log)

2018-08-20 nibe1155 heatpump controller first version
2018-08-28 controlling heat pump
2018-08-29 PCB (kicad) tapeout V0.1
    [MODBUS.sch, rpi-atmega324-modbus-gateway-min.kicad_pcb, rpi-atmega324-modbus-gateway-min.sch, rpi-atmega324-modbus-gateway-min_bom.ods]
2018-08-31 V0.2 Tapeout
    [MODBUS.sch, rpi-atmega324-modbus-gateway-min.kicad_pcb, rpi-atmega324-modbus-gateway-min.sch, rpi-atmega324-modbus-gateway-min_bom.ods]
2022-03-15 test mode
    [MODBUS-2020-11-14-15-20-30.sch, MODBUS-2020-11-14-15-47-13.sch, rpi-atmega324-modbus-gateway-min-2020-11-14-15-20-30.sch, rpi-atmega324-modbus-gateway-min-2020-11-14-15-47-13.sch]
2022-04-12 continous refresh of outdoor temperature
